chickadee-tech/spcr/(commit log)

2015-11-18 v1 of the spacer board
    [ExpansionPort.sch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]
2016-01-26 Add FlightStack branding to the spacer.
    [spacer.kicad_pcb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]
2016-03-05 Spacer v3 which switches to the thin logo and adds OSHW logo.
    [spacer.kicad_pcb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]
2016-04-13 Rebrand everything to Polystack and increment versions.
    [spacer.kicad_pcb]
2016-04-16 Manufacturing test version of spacer including spare resistor. MacroFab doesn't do bare boards.
    [spacer-B.Cu.gbl, spacer-B.Mask.gbs, spacer-B.Paste.gbp, spacer-B.SilkS.gbo, spacer-Edge.Cuts.gm1, spacer-F.Cu.gtl, spacer-F.Mask.gts, spacer-F.Paste.gtp]
2016-06-07 Update polystack logo to bold variant and bump version number.
    [spacer.kicad_pcb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]
2016-07-07 Add license information to many files. PCB design files are CC-BY and code is MIT license.
    [spacer.kicad_pcb, spacer.sch]
2016-07-07 Convert to relative component and footprint paths.
    [ExpansionPort.sch, spacer.sch]
